jrfranks/MoistureController/(commit log)

2023-06-25 Simplify by using builtin voltage comparator.
2023-06-25 Improve debounce logic and eliminate possible lost interrupts.
2026-05-19 Reposition as a low-power embedded reference design - Add detailed power design guide - Add section 'Low-Power Embedded Design: Theory and Coding Techniques" - Document AVR power hierarchy, concrete 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
    [Config.h, MoistureController.ino, Power.h, Types.h]
2026-08-25 Ship Milestone 1 firmware and fix GitHub 404s.
    avr-ultra is now a scheduled fail-closed controller (close pulse on
    reset, DS3231 wake, gated sensing, CRC EEPROM, six-layer safety)
    instead of a Milestone 0 sleep skeleton.
    Add the missing Makefile, AVR toolchain file, and wiring diagram so
    those README links stop 404ing. make test runs host unit tests.
    [Config.h, Logic.h, MoistureController.ino, Persist.h, Power.h, RTC_DS3231.h, Safety.h, Sensor.h]
2026-08-25 Extract cycle policy so host tests cover fail-closed paths.
    Move persist slot choice and the six-layer decision into Policy.h.
    Safety/Persist become I/O adapters. evaluate_cycle mutates state
    in place to avoid flash bloat. make test is now 165 cases including
    FAULT, RTC lost, battery streak, windows, budget, soak, and Layer 4.
    [Logic.h, Persist.h, Policy.h, RTC_DS3231.h, Safety.h]
